diyan07-ctrl/Quadruped107/docs/evidence/ENVIRONMENT_BASELINE.md

# Environment baseline

Inspected Phase 0.1 head a629397e3cce82819e5d8a52db8938aa93af840c. PRs #1 and #2 remain unmerged. New branch: phase1/software-vision-digital-twin.

SSH BatchMode/StrictHostKeyChecking attempts to diyan07@192.168.1.42 and diyan07@diyan07.local returned `connect to host ... port 22: Permission denied` from this Windows environment before authentication. No credentials were requested, displayed or copied. No Pi command executed, no service was inspected/changed, and Telegram was untouched.

Pi OS, 2 GB RAM, camera identity/YUYV formats and historical approximately 7.77/7.75 FPS are user-supplied observations, not measurements from this run. CSI IMX219 is reported faulty; HW-170 is suspected damaged. Both remain unused; physical actuation and power switching are prohibited.

Local saved Python environment is unusable from prior inspection; CI supplies Python, Arduino CLI and headless PyBullet validation. No physical Uno is connected or uploaded. All new hardware measurements are BLOCKED — HARDWARE UNAVAILABLE / NETWORK ACCESS DENIED.
