diyan07-ctrl/Quadruped107/archive/uno-q/control-station/README.md

> Historical UNO Q application. Not supported on Raspberry Pi / Uno R3. See [archive status](../README.md).

# UNO Q Control Station

Nueva app independiente para controlar el robot cuadrúpedo UNO Q sin reemplazar `uno-q-keyboard-motion`.

## Qué incluye

- Feed de cámara por snapshots en `/api/camera-frame`.
- Stream MJPEG en `http://<host>:7001/video-feed`.
- UI tipo focus view centrada en video con HUD.
- Modo Manual con teclado o controles tipo ROG Ally:
  - Arrow Down: `initial`
  - Arrow Up: `stand`
  - Arrow Right: `greeting`
  - W hold: `forward`
  - S hold: `backward`
  - A hold: `turn_left`
  - D hold: `turn_right`
  - Escape: focus/camera view
  - Space: `manual`
  - PageDown: `opencv`
  - F4: `hand_gesture`
- Modo OpenCV con tracking básico de pelota azul:
  - Máscara HSV azul.
  - Detector estricto por contorno circular: radio máximo, circularidad y densidad de relleno.
  - Si no detecta pelota: búsqueda con ráfaga de tres giros a la derecha.
  - Si detecta pelota fuera del centro: corrige con giro izquierdo/derecho.
  - Si detecta pelota centrada: avanza hacia adelante.
  - Si la pelota ya se ve grande/cerca: deja de mandar nuevos movimientos.
  - Entre movimientos espera 1.5 segundos sin mandar `stand`, para no revertir el avance o el giro recién hecho.
  - El feed muestra una vista anotada mientras OpenCV está activo.
- Modo Hand Gesture usando solo el brick `arduino:video_object_detection`:
  - Usa un modelo Edge Impulse en `/home/arduino/.arduino-bricks/ei-models/hand_gesture.eim`.
  - El brick detecta gestos de mano desnuda y entrega etiqueta, confianza y bounding box.
  - La app usa solo las cuatro etiquetas del modelo incluido:
    `five -> turn_right`, `good -> forward`, `neut -> backward`, `peace -> greeting`.
  - El mismo gesto se dispara una vez, con cooldown de 2.5 segundos, para evitar que un reconocimiento sostenido bloquee el control.
  - Las cajas anotadas expiran rapido para que el feed vuelva al video vivo si el brick deja de enviar detecciones.
  - Si no detecta mano o la etiqueta no esta mapeada: no manda movimiento.
  - La camara del brick usa `/dev/video0` directo y alimenta tambien el feed de la UI.
  - OpenCV queda reservado solo para el modo de pelota azul.
- Sketch con PCA9685 en `0x40`, canales `0-7`, `50 Hz`, reutilizando pulsos, poses y gait del prototipo.
  - `Shoulder_FR` calibrado en la app nueva con `initial=395`, `stand=330`; greeting usa `350` como soporte y fuerza retorno a `330`.

## Arquitectura de movimiento

La UI ya no encola un request por cada step mientras una tecla está presionada. Ahora publica cambios de estado con:

- `POST /api/mode` `{ "mode": "forward" }`
- `POST /api/mode` `{ "mode": "backward" }`
- `POST /api/mode` `{ "mode": "turn_left" }`
- `POST /api/mode` `{ "mode": "turn_right" }`
- `POST /api/mode` `{ "mode": "stand" }`
- `POST /api/mode` `{ "mode": "manual" }`
- `POST /api/mode` `{ "mode": "opencv" }`
- `POST /api/mode` `{ "mode": "hand_gesture" }`

`python/main.py` contiene `MotionController`, un worker único que serializa llamadas al Bridge, mantiene `desired_motion`, `current_motion` y `generation`, y descarta respuestas obsoletas. Si cambias rápido de `D` a `W`, la UI manda `turn_right` y luego `forward`; al soltar `D` no manda `stand` mientras `W` siga activo.

Los workers de vision no llaman al Bridge directamente. OpenCV lee el ultimo frame disponible; el brick de gestos recibe detecciones de Edge Impulse. Ambos publican el movimiento deseado en `MotionController`, para que los movimientos autonomos y manuales usen la misma cola serializada.

El sketch expone:

- `run_motion(motion)` para compatibilidad con el prototipo anterior.
- `run_mode_step(mode)` para la estación nueva.

Los steps siguen siendo bloqueantes dentro de Arduino mientras están ejecutando, pero Python deja de construir cola implícita y siempre toma el último modo deseado cuando el step actual termina.

## Endpoints principales

- `GET /api/state`
- `POST /api/mode`
- `GET /api/mode/<mode>`
- `GET /api/camera-frame`
- `GET http://<host>:7001/video-feed`

## Archivos

- `assets/index.html`: UI de control station.
- `assets/app.js`: estado de teclado, `set_mode`, camera refresh y HUD.
- `assets/styles.css`: layout responsive y focus view.
- `python/main.py`: cámara, MJPEG, MotionController y workers de visión.
- `sketch/sketch.ino`: movimientos, pulsos y Bridge functions.
