diyan07-ctrl/Quadruped107/hardware/cad/Quadruped107.step

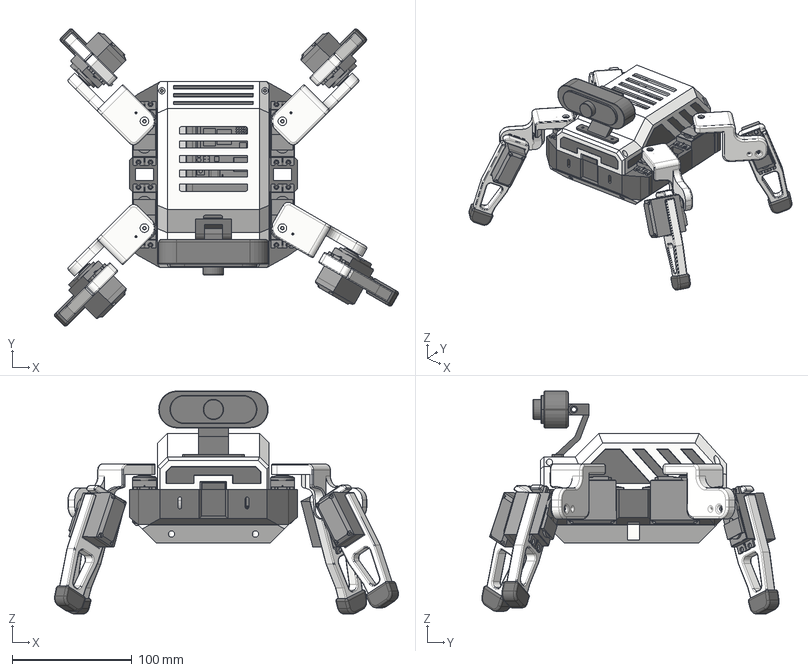
[picture p1: CAD file, 2026-11-04]
hardware/cad/Quadruped107.step
286.8 x 247.8 x 185.9 mm
MG996R_servo x 4
Document
Battery 12v
(Unsaved)
Hub
Power_bank
Camera
Base
Case
Base:cover
camera atachment v1
Servo Horns x 2
MG996R_servo_3 x 2
LegBR
Servo Horns_1 x 2
Servo Horns_2 x 2
Servo Horns_3 x 2
LegBR(Mirror) (4)
MG996R_servo_1
LegBR(Mirror) (4)(Mirror)
MG996R_servo_2
LegBR(Mirror) (4)(Mirror)(Mirror)
