diyan07-ctrl/Quadruped107/hardware/stl/ShoulderFL.stl

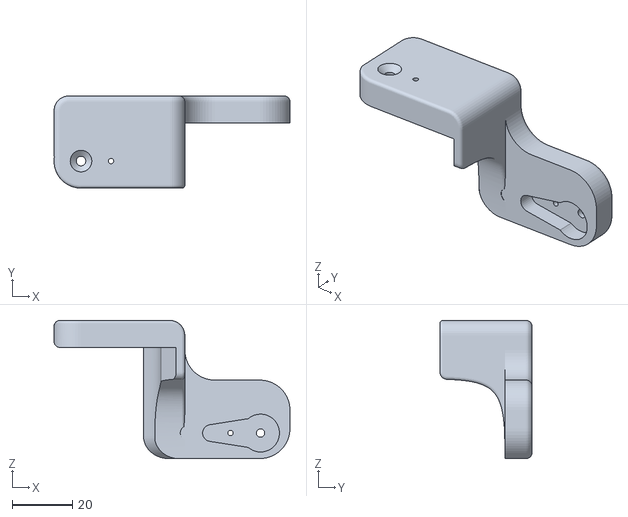
[picture p2: CAD file, 2026-11-04]
hardware/stl/ShoulderFL.stl
78.6 x 30.7 x 46.0
