diyan07-ctrl/Quadruped107/hardware/stl/Dec_side_2.stl

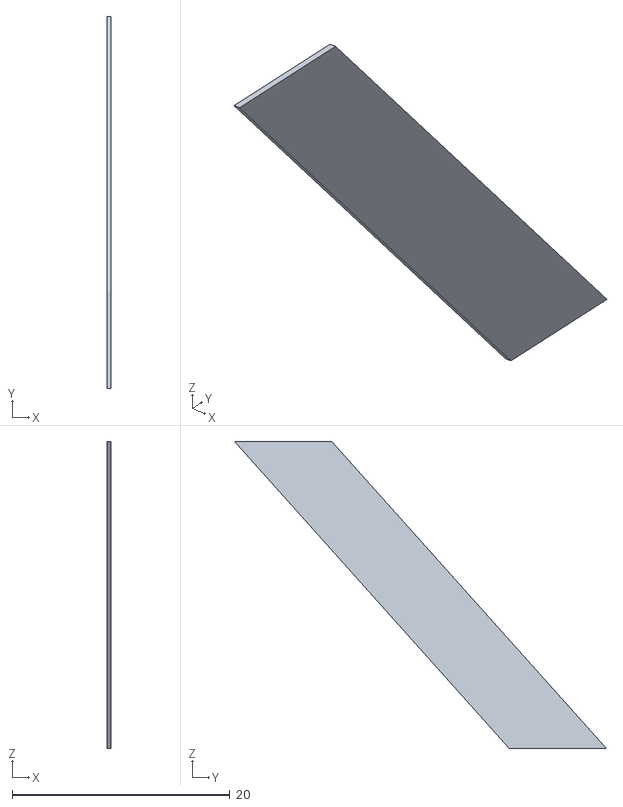
[picture p3: CAD file, 2026-11-04]
hardware/stl/Dec_side_2.stl
0.4 x 34.2 x 28.2
