diyan07-ctrl/Quadruped107/hardware/stl/LegBR.stl

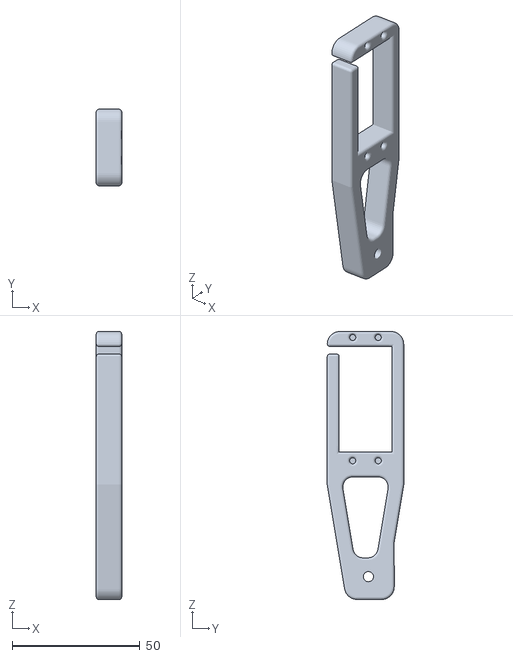
[picture p4: CAD file, 2026-11-04]
hardware/stl/LegBR.stl
10.0 x 30.0 x 105.0
