diyan07-ctrl/Quadruped107/hardware/stl/Dec_back_4.stl

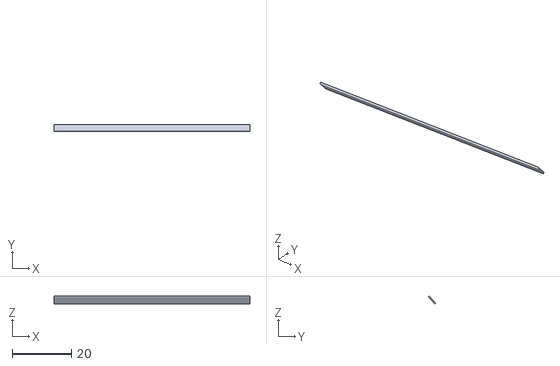
[picture p5: CAD file, 2026-11-04]
hardware/stl/Dec_back_4.stl
66.2 x 2.42 x 2.63
