diyan07-ctrl/Quadruped107/hardware/stl/Dec_Front_2.stl

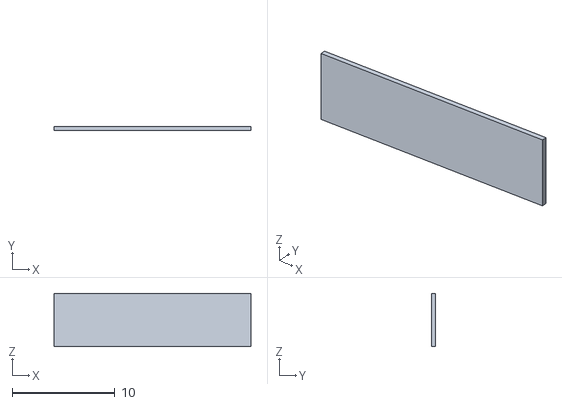
[picture p6: CAD file, 2026-11-04]
hardware/stl/Dec_Front_2.stl
19.2 x 0.4 x 5.20
