diyan07-ctrl/Quadruped107/hardware/stl/Dec_front_1.stl

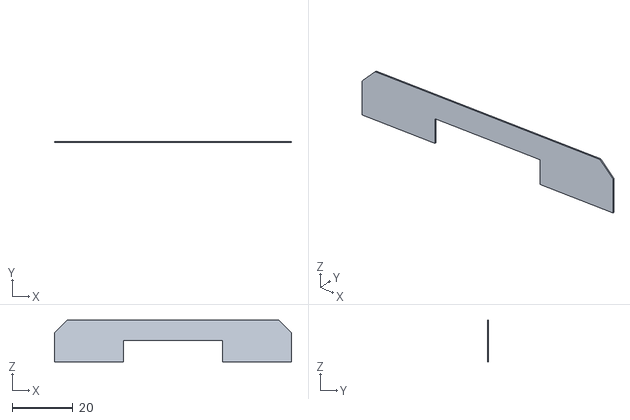
[picture p7: CAD file, 2026-11-04]
hardware/stl/Dec_front_1.stl
78.2 x 0.4 x 13.7
