diyan07-ctrl/Quadruped107/hardware/stl/FootBR.stl

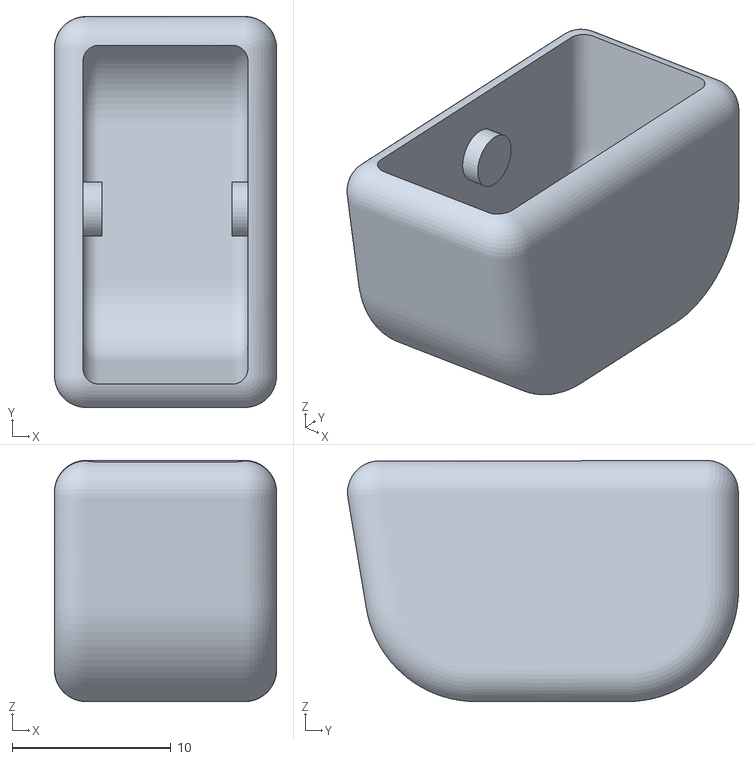
[picture p8: CAD file, 2026-11-04]
hardware/stl/FootBR.stl
14.0 x 24.6 x 15.2
