diyan07-ctrl/Quadruped107/hardware/stl/Dec_back_2.stl

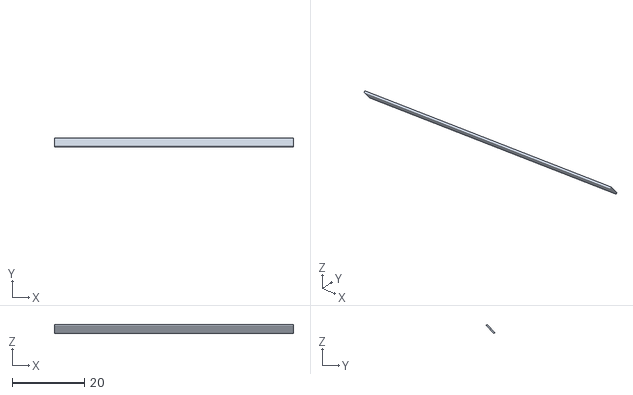
[picture p9: CAD file, 2026-11-04]
hardware/stl/Dec_back_2.stl
66.2 x 2.39 x 2.60
