diyan07-ctrl/Quadruped107/hardware/stl/Case.stl

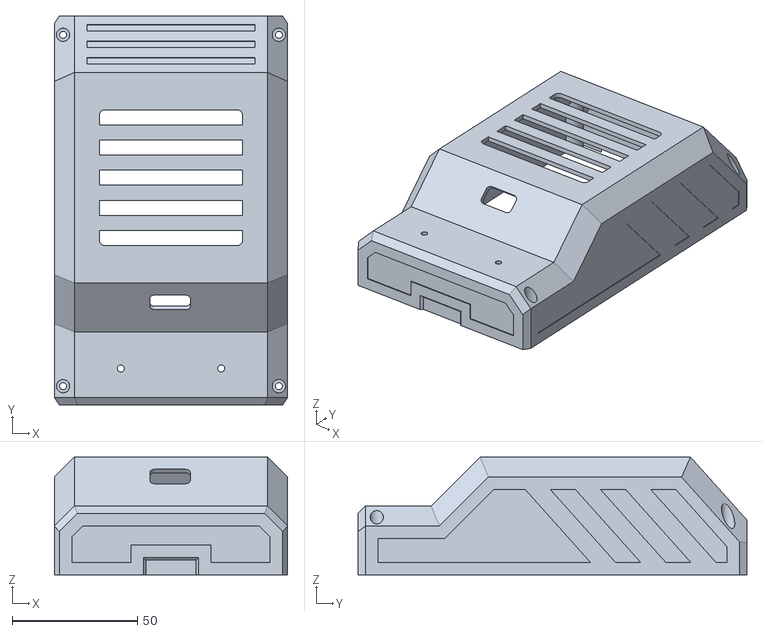
[picture p10: CAD file, 2026-11-04]
hardware/stl/Case.stl
93.0 x 155.0 x 47.0
