diyan07-ctrl/Quadruped107/hardware/stl/Dec_side_4.stl

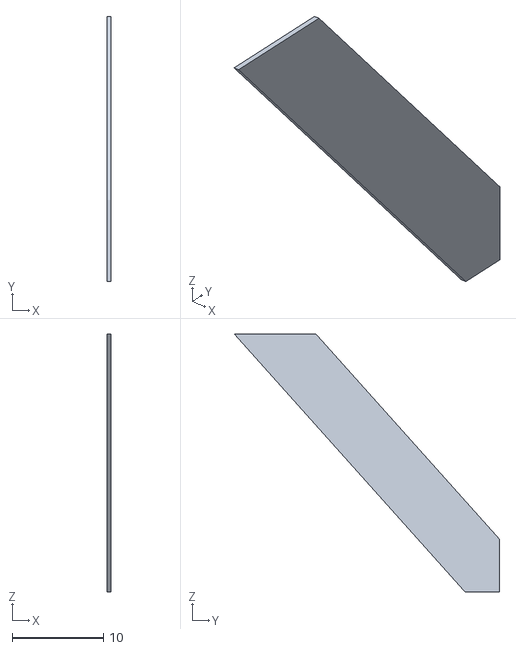
[picture p11: CAD file, 2026-11-04]
hardware/stl/Dec_side_4.stl
0.4 x 29.0 x 28.2
