diyan07-ctrl/Quadruped107/hardware/stl/Dec_back_3.stl

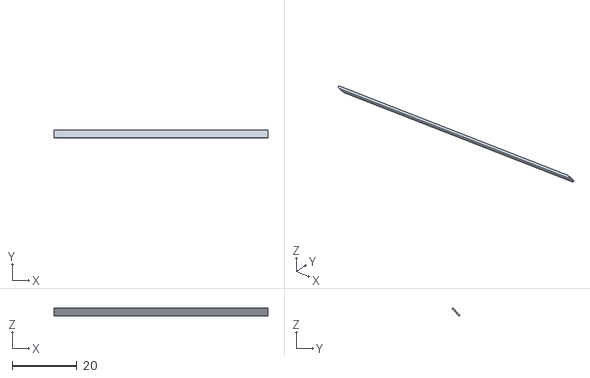
[picture p12: CAD file, 2026-11-04]
hardware/stl/Dec_back_3.stl
66.2 x 2.35 x 2.56
