diyan07-ctrl/Quadruped107/hardware/stl/Base.stl

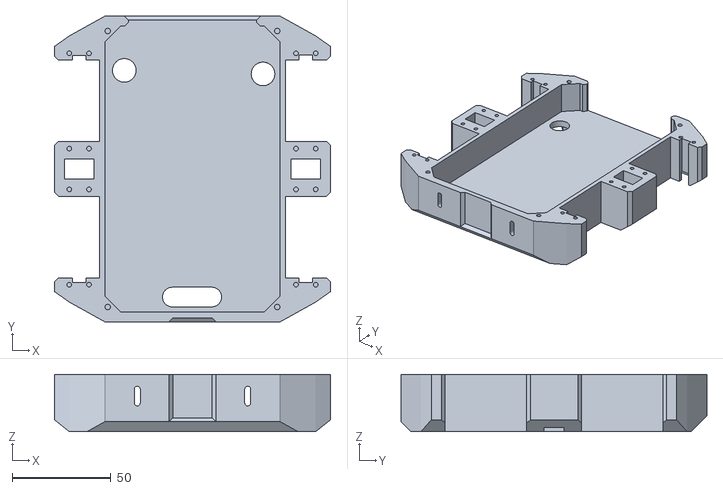
[picture p13: CAD file, 2026-11-04]
hardware/stl/Base.stl
140.0 x 155.0 x 29.0
