diyan07-ctrl/Quadruped107/hardware/stl/Dec_side_1.stl

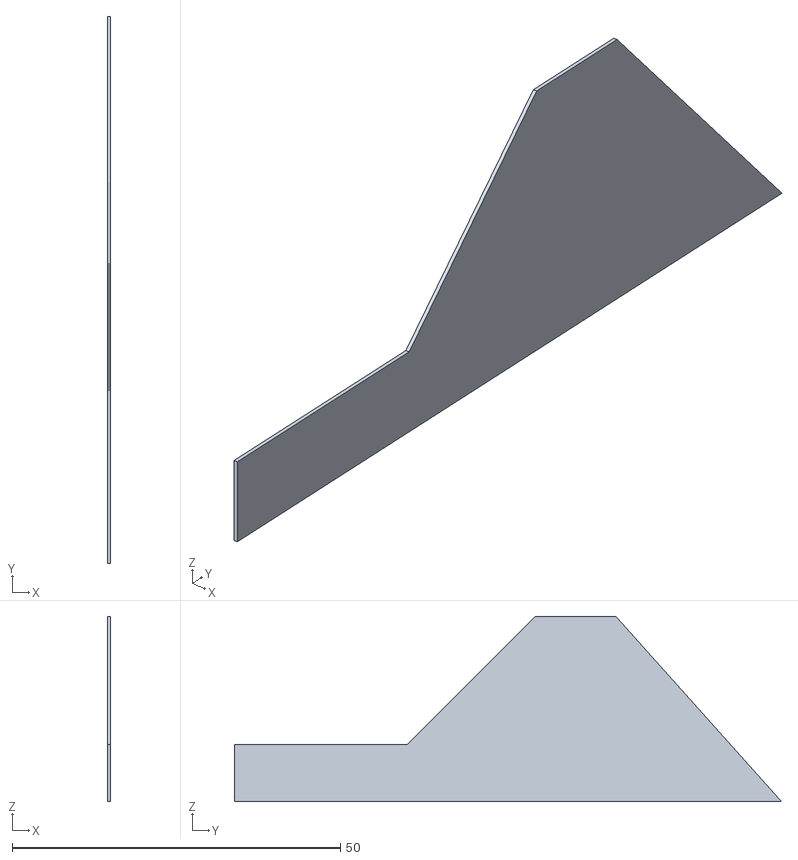
[picture p14: CAD file, 2026-11-04]
hardware/stl/Dec_side_1.stl
0.4 x 83.3 x 28.2
