diyan07-ctrl/Quadruped107/hardware/stl/Dec_back_1.stl

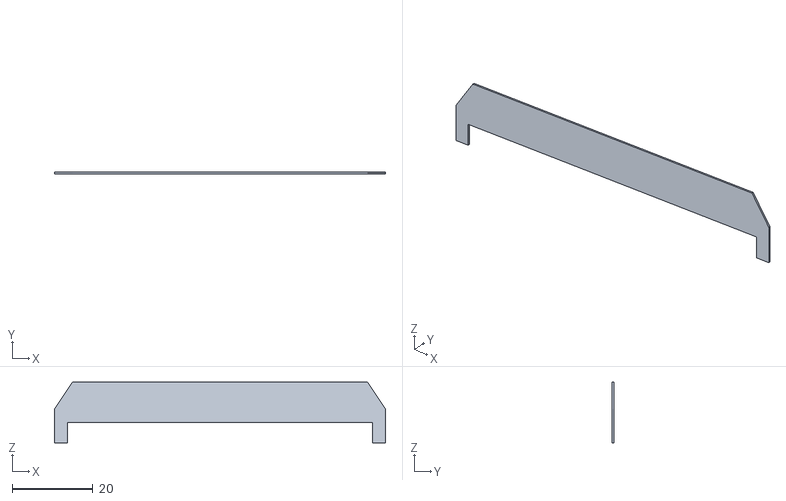
[picture p15: CAD file, 2026-11-04]
hardware/stl/Dec_back_1.stl
82.2 x 0.4 x 15.1
