diyan07-ctrl/Quadruped107/(list of files, cad)

Other CAD files:
hardware/stl/ShoulderBR.stl
hardware/stl/ShoulderFR.stl
hardware/stl/LegBL.stl
hardware/stl/Dec_side_3.stl
hardware/stl/ShoulderBL.stl
hardware/stl/FootFR.stl
hardware/stl/LegFR.stl
hardware/stl/FootBL.stl
hardware/stl/LegFL.stl
hardware/cad/Quadruped107.f3z
