diyan07-ctrl/Quadruped107/docs/HARDWARE_VERIFICATION.md

# HARDWARE_VERIFICATION — sole physical qualification checklist

## Phase 2 deferral

PHYSICAL HARDWARE TESTED: none. Pi deployment, SSH access, real sensors, Uno/PCA connection, power switching and servo movement are deliberately postponed; no connection is attempted.

Before later physical sensing: identify exact URM37/HC-SR04 revisions and interfaces, voltage levels, safe pinout and acoustic scheduling; qualify touch polarity, placement, debounce and roles. Implement and test Uno local safety plus negotiated telemetry separately. Simulated swept-volume flags have no physical equivalent until additional qualified sensing provides it. Existing power, damaged-PCA isolation, calibration, watchdog/OE and independent disconnect requirements remain unchanged.

## Current assignment gate: no physical actuation

All physical checks below remain pending unless separately supported by existing evidence. This session performed no power, servo, sensor or Pi measurements. SSH to both the reported IP and hostname failed with port-22 Permission denied before authentication. No credentials or Telegram configuration were read.

- [ ] Restore authorized SSH/key connectivity without sharing secrets; enumerate current OS/RAM/storage, services, ports and V4L2 devices before deployment.
- [ ] Validate the USB2.0 PC CAMERA with V4L2/YUYV; measure actual FPS/frame age, hot-unplug/recovery, frozen/slow capture behavior and native shutdown on Pi.
- [ ] Run real camera + **explicit virtual actuators**, laptop bridge and dashboard; measure CPU/RSS, perception age, target-loss/STOP and network-recovery behavior.
- [ ] Recover actual CAD assembly joint pivots/axes/export transforms, link masses/COM/inertias and physical servo-angle mapping before treating PyBullet as a locomotion predictor.
- [ ] Keep the suspected damaged HW-170 isolated until a qualified electrical assessment/replacement; never test it by connecting servos.
- [ ] Qualify battery/BMS/regulator/wiring/fusing/disconnect/OE/watchdog and individual calibration before separately authorized physical motion.

Software simulation does not clear any electrical or movement gate. [Power evidence](../hardware/Power/TEST_PLAN.md) and [simulation acceptance](../simulation/README.md) specify separate procedures.

All items below are **PENDING / NOT VERIFIED**. No photos, labels, electrical measurements or hardware tests were collected during Phase 0/0.1. This is the authoritative register of unresolved module-specific questions; other documents define requirements and test methods.

For each item record specimen/assembly ID, exact manufacturer document/revision, date, setup, instruments, conditions, evidence path, result and reviewer. Do not mark passed from a simulator or seller title.

- [ ] **HV01 Batteries P1/P2/P3:** exact cell chemistry/configuration and age; pack/BMS continuous/transient/disconnect limits; polarity/connectors; charge and per-cell cutoff rules; cell balance, damage, safe resistance/sag and delivered-Wh tests.
- [ ] **HV02 Power bank and cable:** output profiles at 5 V, actual sustained/transient rating, cable resistance, Pi 4 boot/CV/camera/USB load voltage, low-load shutdown, multi-port renegotiation, pass-through behavior and remaining energy/OS shutdown indication.
- [ ] **HV03 Servos:** exact MG996R/MG995 variant for each joint, supply/temperature/pulse ratings, direction/ID, connector/lead current, unloaded/holding/gait/transient current and condition; ninth servo separate.
- [ ] **HV04 Converter:** exact SKU/topology, safe input window and dropout, fixed/adjusted accuracy, start/stop overshoot, load-step response, true continuous thermal capacity, peak duration, quiescent loss, current limit/hiccup, UV/OV/thermal protection and regeneration handling.
- [ ] **HV05 Distribution/protection:** PCA breakout schematic/copper/terminal ratings; external harness loop resistance, conductor/contact ratings, fuse time-current/I²t and interrupt coordination, DC disconnect rating, reverse protection, grounding and no branch-positive bridging.
- [ ] **HV06 OE and partial power:** actual pull-up/pull-down network, logic-only/servo-only states, boot/reset/high-impedance behavior, no phantom powering through PWM/I2C/USB, independent rail power-good/UV/OV latch and explicit restart.
- [ ] **HV07 Uno safety:** bootloader version and watchdog-reset compatibility, actual fuses/BOD configuration and 16 MHz voltage envelope, early reset/OE behavior, 1 s watchdog candidate tolerance/progress servicing, I2C fault propagation, stopped CPU and lost-Pi tests.
- [ ] **HV08 Physical stop:** accessible independently rated servo-power interrupt covering every branch, latched restart behavior and mechanical support; D12 is proposed status only, not a working circuit.
- [ ] **HV09 Calibration/mechanics:** fixture and first-movement procedure, safe neutral/endpoints/rates and evidence for each joint, software-profile/table compatibility, clearances, mount/cooling/cable strain, stable supported and unsupported gait acceptance.
- [ ] **HV10 Range modules:** URM37 revision/pin labels/mode/voltage and pulse conversion; HC-SR04 revision/echo level; blind zones, timeout, placement, acoustics/crosstalk and selected-source validity.
- [ ] **HV11 Touch modules:** model, supply/output topology/active polarity, placement, safety-versus-interaction classification, debounce/stuck-state behavior and cable noise.
- [ ] **HV12 Optional OLED/pan:** OLED controller/panel/address/3.3 V interface and pull-ups on Pi bus; measured display load; pan servo range/mount/profile/load and separate current-envelope approval.
- [ ] **HV13 Monitoring:** battery/servo-rail sense and power-good circuit, divider/max input/transient rating, ADC reference/error/filtering and unpowered leakage; thresholds must derive from HV01/HV03/HV04.
- [ ] **HV14 CSI/Pi measurements:** camera model/ribbon, correct colour/orientation, capture SensorTimestamp clock domain and metadata age, actual frame backlog/latency, resource load and recovery while driving/streaming.
- [ ] **HV15 Integrated evidence:** measured STOP→OE and STOP→torque response, browser/USB/Pi failure recovery, no automatic movement after rail restoration, temperatures, usable runtime and reproducible demonstration course limits.

Use [power test methods](../hardware/Power/TEST_PLAN.md), [calibration contract](CALIBRATION.md), [safety design](SAFETY.md), and [validation evidence](VALIDATION.md). Electrical approval remains blocked until the applicable items pass. Supported isolated-joint commissioning can begin only with a qualified limited-energy source, independently working disconnect and a reviewed fixture procedure.

## Phase 3 remaining physical verification (NOT TESTED)

- [ ] Confirm current Pi address and authorized SSH path; inspect existing services/environments without replacing Telegram/SSH configuration.
- [ ] Qualify Python 3.13 OS OpenCV/NumPy and report actual pip-check warnings before remediation.
- [ ] Verify USB V4L2 ownership, blue/yellow BGR/HSV behavior, lighting/false positives, unplug/recovery and sustained capture/processing FPS, observation age, CPU/RAM.
- [ ] Recover mechanical pivots/axes, link masses/inertia and real servo calibration; investigate modeled contacts before using physics as locomotion evidence.
- [ ] Keep damaged PCA9685 isolated. Independently qualify replacement/repair, regulated power, fusing, physical disconnect, OE/reset and watchdog/local safety before any future physical ARM.
- [ ] Verify future TEL1 source acquisition age, touch debounce, actual output-enable state and local STOP independent of Pi; passive host parsing provides none of these hardware guarantees.

No item above was completed through the unsuccessful Phase 3 network probe. See [operator procedure](PHASE3.md).
