diyan07-ctrl/Quadruped107/Dev/Tools/uno-q-servo-calibrator/assets/index.html

# UNO Q Servo Calibrator

PCA9685 channel calibration for the quadruped robot.

Connecting Save Export JSON

## Active Servo

Channel 0

70-495

PCA9685 Channel Pulse Value

Send

-5 -1 +1 +5

Current 300

Reference Min 70

Reference Max 495

Ready

## Camera Feed

Starting camera

MJPEG

Camera unavailable

## Saved Working Values

Values update locally after each successful servo command.

Articulation | Channel | Pulse Min 0 deg | Pulse Max 180 deg | Current Pulse
