diyan07-ctrl/Quadruped107/hardware/calibration/key bindings (Rog_Ally).xlsx

Key Bindings
Keys | Animation/Movemnet/Mode
w | Gait forwardit
s | Gait backward
a | Left turn
d | Right turn
up arrow | Stand
down arrow | Inital
Rigth arrow | Hi/greeting
left arror
(X) Page down key | OpenCV (Blue ball detection)
(Y)F4 | Mediapipe (Hand controller)
(A) space key | Manual mode
(B) Esc Key
