diyan07-ctrl/Quadruped107/hardware/calibration/Servo calibration table.xlsx

Calibracion de servos
 |  |  |  |  | Shoulders |  | arms
Articulacion | Canal | angulo_min | Angulo_max | punto medio | 0° | 90° | vertical_down | vertical_up
Shoulder_FL | 0 | 395 | 160 | 280 | 380 | 175
Leg_FL | 1 | 75 | 530 | 305 |  |  | 110 | 513
Shoulder_FR | 2 | 145 | 395 | 265 | 215 | 440
Leg_FR | 3 | 540 | 75 | 295 |  |  | 500 | 90
Shoulder_BL | 4 | 170 | 425 | 295 | 185 | 405
Leg_BL | 5 | 540 | 75 | 280 |  |  | 495 | 75
Shoulder_BR | 6 | 410 | 160 | 280 | 390 | 175
Leg_BR | 7 | 75 | 535 | 310 |  |  | 110 | 525
 |  |  |  |  | *shoulders 0° and 90° relative to the body
 |  |  |  |  | *arms verticaldown and upl relative to the floor
