diyan07-ctrl/Quadruped107/simulation/model/robot.urdf

<?xml version="1.0"?>
<!-- Provisional axes, origins, masses and collision proxies; not calibrated hardware. -->
<robot name="Quadruped107_PROVISIONAL">
  <link name="chassis">
    <inertial>
      <origin xyz="0 0 0" />
      <mass value="0.8" />
      <inertia ixx="0.0019867333333333337" iyy="0.0016917333333333338" izz="0.002908333333333334" ixy="0" ixz="0" iyz="0" />
    </inertial>
    <visual>
      <origin xyz="0 0 -0.028" />
      <geometry>
        <mesh filename="../../hardware/stl/Base.stl" scale=".001 .001 .001" />
      </geometry>
    </visual>
    <visual>
      <origin xyz="0 0 -0.028" />
      <geometry>
        <mesh filename="../../hardware/stl/Case.stl" scale=".001 .001 .001" />
      </geometry>
    </visual>
    <collision>
      <origin xyz="0 0 0" />
      <geometry>
        <box size="0.14 0.155 0.076" />
      </geometry>
    </collision>
  </link>
  <link name="upper_fl">
    <inertial>
      <origin xyz="0 0 -0.03928563309" />
      <mass value="0.12" />
      <inertia ixx="7.073443868235278e-05" iyy="7.073443868235278e-05" izz="1.8e-05" ixy="0" ixz="0" iyz="0" />
    </inertial>
    <visual>
      <origin xyz="-0.0175 0.03815464687 0.0485" rpy="0 1.5707963267948966 0" />
      <geometry>
        <mesh filename="../../hardware/stl/ShoulderFL.stl" scale=".001 .001 .001" />
      </geometry>
      <material name="cad">
        <color rgba=".25 .45 .65 1" />
      </material>
    </visual>
    <collision>
      <origin xyz="0 0 -0.03928563309" />
      <geometry>
        <box size="0.025 0.025 0.07857126617" />
      </geometry>
    </collision>
  </link>
  <link name="lower_fl">
    <inertial>
      <origin xyz="0 0 -0.05250000095" />
      <mass value="0.08" />
      <inertia ixx="7.950000267028811e-05" iyy="7.416666933695478e-05" izz="6.6666666666666675e-06" ixy="0" ixz="0" iyz="0" />
    </inertial>
    <visual>
      <origin xyz="-0.05269137573 0.09628407288 -0.01950226784" rpy="0 0 0" />
      <geometry>
        <mesh filename="../../hardware/stl/LegFL.stl" scale=".001 .001 .001" />
      </geometry>
      <material name="cad">
        <color rgba=".25 .45 .65 1" />
      </material>
    </visual>
    <visual>
      <origin xyz="-0.05269137573 0.09532604218 -0.02510119057" rpy="0 0 0" />
      <geometry>
        <mesh filename="../../hardware/stl/FootFL.stl" scale=".001 .001 .001" />
      </geometry>
      <material name="cad">
        <color rgba=".25 .45 .65 1" />
      </material>
    </visual>
    <collision>
      <origin xyz="0 0 -0.05250000095" />
      <geometry>
        <box size="0.01 0.025 0.1050000019" />
      </geometry>
    </collision>
    <collision>
      <origin xyz="0 0 -0.1050000019" />
      <geometry>
        <box size="0.02 0.025 0.015" />
      </geometry>
    </collision>
  </link>
  <joint name="shoulder_fl" type="revolute">
    <parent link="chassis" />
    <child link="upper_fl" />
    <origin xyz="0.0525 0.0955 -0.038" />
    <axis xyz="0 1 0" />
    <limit lower="-1.2" upper="1.2" effort=".5" velocity="3" />
    <dynamics damping=".05" friction=".01" />
  </joint>
  <joint name="leg_fl" type="revolute">
    <parent link="upper_fl" />
    <child link="lower_fl" />
    <origin xyz="0 0 -0.07857126617" />
    <axis xyz="0 1 0" />
    <limit lower="-1.2" upper="1.2" effort=".5" velocity="3" />
    <dynamics damping=".05" friction=".01" />
  </joint>
  <link name="upper_fr">
    <inertial>
      <origin xyz="0 0 -0.03928563309" />
      <mass value="0.12" />
      <inertia ixx="7.073443868235278e-05" iyy="7.073443868235278e-05" izz="1.8e-05" ixy="0" ixz="0" iyz="0" />
    </inertial>
    <visual>
      <origin xyz="0.0175 0.03815464687 0.0485" rpy="0 1.5707963267948966 0" />
      <geometry>
        <mesh filename="../../hardware/stl/ShoulderFR.stl" scale=".001 .001 .001" />
      </geometry>
      <material name="cad">
        <color rgba=".25 .45 .65 1" />
      </material>
    </visual>
    <collision>
      <origin xyz="0 0 -0.03928563309" />
      <geometry>
        <box size="0.025 0.025 0.07857126617" />
      </geometry>
    </collision>
  </link>
  <link name="lower_fr">
    <inertial>
      <origin xyz="0 0 -0.05250000095" />
      <mass value="0.08" />
      <inertia ixx="7.950000267028811e-05" iyy="7.416666933695478e-05" izz="6.6666666666666675e-06" ixy="0" ixz="0" iyz="0" />
    </inertial>
    <visual>
      <origin xyz="-0.05269137573 0.09628407288 -0.08549773407" rpy="0 0 0" />
      <geometry>
        <mesh filename="../../hardware/stl/LegFR.stl" scale=".001 .001 .001" />
      </geometry>
      <material name="cad">
        <color rgba=".25 .45 .65 1" />
      </material>
    </visual>
    <visual>
      <origin xyz="-0.05269137573 0.09532604218 -0.1848988132" rpy="0 0 0" />
      <geometry>
        <mesh filename="../../hardware/stl/FootFR.stl" scale=".001 .001 .001" />
      </geometry>
      <material name="cad">
        <color rgba=".25 .45 .65 1" />
      </material>
    </visual>
    <collision>
      <origin xyz="0 0 -0.05250000095" />
      <geometry>
        <box size="0.01 0.025 0.1050000019" />
      </geometry>
    </collision>
    <collision>
      <origin xyz="0 0 -0.1050000019" />
      <geometry>
        <box size="0.02 0.025 0.015" />
      </geometry>
    </collision>
  </link>
  <joint name="shoulder_fr" type="revolute">
    <parent link="chassis" />
    <child link="upper_fr" />
    <origin xyz="0.0525 -0.0955 -0.038" />
    <axis xyz="0 1 0" />
    <limit lower="-1.2" upper="1.2" effort=".5" velocity="3" />
    <dynamics damping=".05" friction=".01" />
  </joint>
  <joint name="leg_fr" type="revolute">
    <parent link="upper_fr" />
    <child link="lower_fr" />
    <origin xyz="0 0 -0.07857126617" />
    <axis xyz="0 1 0" />
    <limit lower="-1.2" upper="1.2" effort=".5" velocity="3" />
    <dynamics damping=".05" friction=".01" />
  </joint>
  <link name="upper_bl">
    <inertial>
      <origin xyz="0 0 -0.03928563309" />
      <mass value="0.12" />
      <inertia ixx="7.073443868235278e-05" iyy="7.073443868235278e-05" izz="1.8e-05" ixy="0" ixz="0" iyz="0" />
    </inertial>
    <visual>
      <origin xyz="0.0175 0.03815464687 0.0485" rpy="0 1.5707963267948966 0" />
      <geometry>
        <mesh filename="../../hardware/stl/ShoulderBL.stl" scale=".001 .001 .001" />
      </geometry>
      <material name="cad">
        <color rgba=".25 .45 .65 1" />
      </material>
    </visual>
    <collision>
      <origin xyz="0 0 -0.03928563309" />
      <geometry>
        <box size="0.025 0.025 0.07857126617" />
      </geometry>
    </collision>
  </link>
  <link name="lower_bl">
    <inertial>
      <origin xyz="0 0 -0.05250000095" />
      <mass value="0.08" />
      <inertia ixx="7.950000267028811e-05" iyy="7.416666933695478e-05" izz="6.6666666666666675e-06" ixy="0" ixz="0" iyz="0" />
    </inertial>
    <visual>
      <origin xyz="-0.05269137573 0.09628407288 -0.08549773407" rpy="0 0 0" />
      <geometry>
        <mesh filename="../../hardware/stl/LegBL.stl" scale=".001 .001 .001" />
      </geometry>
      <material name="cad">
        <color rgba=".25 .45 .65 1" />
      </material>
    </visual>
    <visual>
      <origin xyz="-0.05269137573 0.09532604218 -0.1848988132" rpy="0 0 0" />
      <geometry>
        <mesh filename="../../hardware/stl/FootBL.stl" scale=".001 .001 .001" />
      </geometry>
      <material name="cad">
        <color rgba=".25 .45 .65 1" />
      </material>
    </visual>
    <collision>
      <origin xyz="0 0 -0.05250000095" />
      <geometry>
        <box size="0.01 0.025 0.1050000019" />
      </geometry>
    </collision>
    <collision>
      <origin xyz="0 0 -0.1050000019" />
      <geometry>
        <box size="0.02 0.025 0.015" />
      </geometry>
    </collision>
  </link>
  <joint name="shoulder_bl" type="revolute">
    <parent link="chassis" />
    <child link="upper_bl" />
    <origin xyz="-0.0525 0.0955 -0.038" />
    <axis xyz="0 1 0" />
    <limit lower="-1.2" upper="1.2" effort=".5" velocity="3" />
    <dynamics damping=".05" friction=".01" />
  </joint>
  <joint name="leg_bl" type="revolute">
    <parent link="upper_bl" />
    <child link="lower_bl" />
    <origin xyz="0 0 -0.07857126617" />
    <axis xyz="0 1 0" />
    <limit lower="-1.2" upper="1.2" effort=".5" velocity="3" />
    <dynamics damping=".05" friction=".01" />
  </joint>
  <link name="upper_br">
    <inertial>
      <origin xyz="0 0 -0.03928563309" />
      <mass value="0.12" />
      <inertia ixx="7.073443868235278e-05" iyy="7.073443868235278e-05" izz="1.8e-05" ixy="0" ixz="0" iyz="0" />
    </inertial>
    <visual>
      <origin xyz="-0.0175 0.03815464687 0.0485" rpy="0 1.5707963267948966 0" />
      <geometry>
        <mesh filename="../../hardware/stl/ShoulderBR.stl" scale=".001 .001 .001" />
      </geometry>
      <material name="cad">
        <color rgba=".25 .45 .65 1" />
      </material>
    </visual>
    <collision>
      <origin xyz="0 0 -0.03928563309" />
      <geometry>
        <box size="0.025 0.025 0.07857126617" />
      </geometry>
    </collision>
  </link>
  <link name="lower_br">
    <inertial>
      <origin xyz="0 0 -0.05250000095" />
      <mass value="0.08" />
      <inertia ixx="7.950000267028811e-05" iyy="7.416666933695478e-05" izz="6.6666666666666675e-06" ixy="0" ixz="0" iyz="0" />
    </inertial>
    <visual>
      <origin xyz="-0.05269137573 0.09628407288 -0.01950226784" rpy="0 0 0" />
      <geometry>
        <mesh filename="../../hardware/stl/LegBR.stl" scale=".001 .001 .001" />
      </geometry>
      <material name="cad">
        <color rgba=".25 .45 .65 1" />
      </material>
    </visual>
    <visual>
      <origin xyz="-0.05269137573 0.09532604218 -0.02510119057" rpy="0 0 0" />
      <geometry>
        <mesh filename="../../hardware/stl/FootBR.stl" scale=".001 .001 .001" />
      </geometry>
      <material name="cad">
        <color rgba=".25 .45 .65 1" />
      </material>
    </visual>
    <collision>
      <origin xyz="0 0 -0.05250000095" />
      <geometry>
        <box size="0.01 0.025 0.1050000019" />
      </geometry>
    </collision>
    <collision>
      <origin xyz="0 0 -0.1050000019" />
      <geometry>
        <box size="0.02 0.025 0.015" />
      </geometry>
    </collision>
  </link>
  <joint name="shoulder_br" type="revolute">
    <parent link="chassis" />
    <child link="upper_br" />
    <origin xyz="-0.0525 -0.0955 -0.038" />
    <axis xyz="0 1 0" />
    <limit lower="-1.2" upper="1.2" effort=".5" velocity="3" />
    <dynamics damping=".05" friction=".01" />
  </joint>
  <joint name="leg_br" type="revolute">
    <parent link="upper_br" />
    <child link="lower_br" />
    <origin xyz="0 0 -0.07857126617" />
    <axis xyz="0 1 0" />
    <limit lower="-1.2" upper="1.2" effort=".5" velocity="3" />
    <dynamics damping=".05" friction=".01" />
  </joint>
</robot>
