diyan07-ctrl/Quadruped107/(commit log)

2026-11-04 Initialize Quadruped107 with updated project branding
    [Base.stl, Case.stl, Dec_Front_2.stl, Dec_back_1.stl, Dec_back_2.stl, Dec_back_3.stl, Dec_back_4.stl, Dec_front_1.stl]
2026-11-04 Clean up README and feature CAD design views
2026-11-04 Port robot control to Raspberry Pi 4 camera and Arduino Uno USB serial
2026-11-09 refactor: establish Phase 0 repository and architecture
    Preserve firmware, gait targets, CAD and calibration assets; package the Pi application and repair imports, installation, CI and deployment paths. Archive UNO Q tools and document architecture, wiring, safety, protocol and Phases 0-5.
    Validation: local JavaScript, repository integrity and whitespace checks passed. Local Python and Arduino toolchains are unavailable; remote CI validation is pending.
    [Base.stl, Case.stl, Dec_Front_2.stl, Dec_back_1.stl, Dec_back_2.stl, Dec_back_3.stl, Dec_back_4.stl, Dec_front_1.stl]
2026-11-09 chore: record Phase 0 validation and refresh CI actions
    Record 18 passing tests, installed-wheel checks, preserved assets and Uno compile sizes from successful push and PR runs. Upgrade checkout and setup-python to verified Node 24 releases, pin the latest Arduino setup action, limit CI permissions and check dependency consistency.
    Validation: prior application and firmware CI passed; local repository integrity, JavaScript syntax and staged whitespace checks passed. Final-head CI follows publication.
2026-11-09 docs: finalize audit findings and validation evidence
    Classify unused inherited constants and record successful Python, dependency and Uno checks on the refreshed CI toolchain. No runtime or firmware behavior changes.
    Validation: local repository integrity, JavaScript syntax and staged whitespace checks passed; both preceding head push and PR workflows passed.
2026-11-09 feat: harden motion arbitration and add power engineering calculations
    Add bounded priority STOP transactions, cancellation barriers, generation-safe controller operations, HTTP operator ownership and failure-path tests without changing protocol v1 or firmware targets. Add the standard-library power model, full Power study, offline calibration contract, telemetry/watchdog design and hardware qualification register.
    Local syntax, repository integrity and staged whitespace checks passed. Local Python/Arduino tools remain unavailable; CI will run tests, compile firmware and produce canonical power tables before the final documentation freeze.
    [calibration.py, camera.py, controller.py, main.py, power_budget.py, serial_link.py]
2026-11-09 test: close stale-inference gaps and extend safety validation
    Expire vision observations independently of blocked image processing, tie results to control generation/session, retain first faults, and test real-worker reconnection and camera queue settings. Install canonical calculator-generated power tables, expand power-bank qualification and enforce table drift checks without CI rewriting tracked files.
    Validation: initial 42-test CI, package, Mermaid and Uno compile passed; local repository/syntax/whitespace checks passed. Updated code and extended tests require the new CI run.
    [camera.py, controller.py, main.py, power_budget.py, serial_link.py]
2026-11-09 fix: preserve inherited vision source during clean-tree validation
    The complete 46-test, power-table, wheel, diagram and Uno checks passed, but CI's final clean-tree assertion exposed an inherited CRLF/LF attribute mismatch. Preserve vision.py bytes explicitly instead of normalizing/reformatting working source, and record the failed run and remedy.
    Local repository integrity, source blob equality and staged whitespace checks passed. Full CI rerun follows.
2026-11-09 docs: freeze architecture and record remaining hardware checks
    Record complete passing 46-test, power-table, wheel, Mermaid, clean-tree and Uno verification after the line-ending fix. Clarify external motor distribution, proposed independent overvoltage power cut, conditional battery tradeoffs and 20-second service shutdown grace.
    All installed batteries/converters and physical protection remain NOT YET QUALIFIED; no servo tables or hardware features changed. Local repository/syntax/whitespace checks passed; final-head CI follows.
2026-11-09 docs: clarify touch telemetry freshness and close verification record
    Specify bounded interval coalescing for future touch reports and clear history on reconnect so brief contacts are represented without replaying stale interactions. Record passing final-freeze push and PR workflows. No sensor implementation or runtime change.
    Validation: previous final freeze passed all 46 tests, package/power/Mermaid/clean-tree checks and Uno compilation. Local documentation/repository and staged whitespace checks passed.
2026-11-09 feat: add USB camera, virtual Uno and safe visual decisions
    Retain the Phase 0.1 safety controller and 46-test baseline while adding explicit camera/actuator selection, V4L2 YUYV capture diagnostics/recovery, configurable blue perception and deterministic virtual-only decisions. Execute the preserved firmware gait tables in a bounded host Uno emulator with real protocol acknowledgments and watchdogs. Physical ARM is prohibited by the application.
    Local repository/whitespace checks passed. SSH to the recorded Pi IP and hostname is denied by local network permissions; no hardware tests or services were touched. New software tests and data parity checks await CI.
2026-11-09 feat: integrate bounded simulation bridge and CAD articulated fixture
    [bridge.py, generate-virtual-firmware.py, main.py]
2026-11-09 test: validate CAD articulation and document safe virtual deployment
    [robot.urdf]
2026-11-09 fix: complete direction and STOP coverage with current CI artifacts
    [autonomy.py, main.py]
2026-11-09 fix: stabilize passive model limits and fail virtual overflow closed
    [virtual_uno.py]
2026-11-09 fix: enforce virtual link identity and freeze simulation evidence
    [main.py]
2026-11-09 fix: require fresh disarmed bridge state and atomic mode takeover
    [bridge.py, controller.py, virtual_uno.py]
2026-11-09 fix: anchor the CAD fixture and validate tracking safety integration
    [controller.py, generate-blue-video.py, main.py]
2026-11-09 docs: specify virtual sensor safety and reproducible Phase 2 scenarios
2026-11-09 test: cover sensor lifecycle, replay barriers and model initialization
2026-11-09 test: verify scene reset, dashboard safety and quantified model evidence
    [check-installed.py]
2026-11-09 fix: measure ACK receipt age and repair dashboard fetch fixture
    [bridge.py]
2026-11-09 Phase 3: display actual selected target color in camera overlay
2026-11-09 Phase 3: add standalone bounded Pi USB camera recorder
2026-11-10 test: qualify fresh camera recovery and concurrent configuration changes
